immortal-sniper1/Ethernet_switch/Ethernet_switch_4out/DOCs/architecture.png

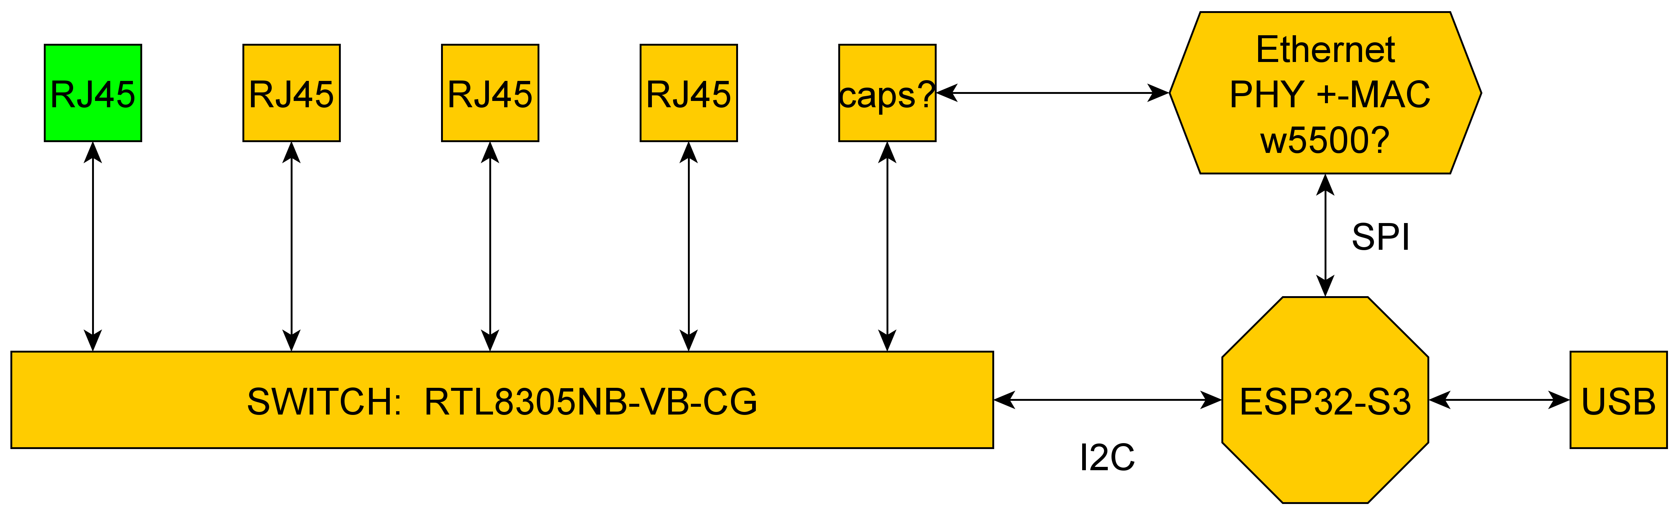
Ethernet_switch_4out/DOCs/architecture.png
