immortal-sniper1/Ethernet_switch/Ethernet_switch_4out/DOCs/pins1.png

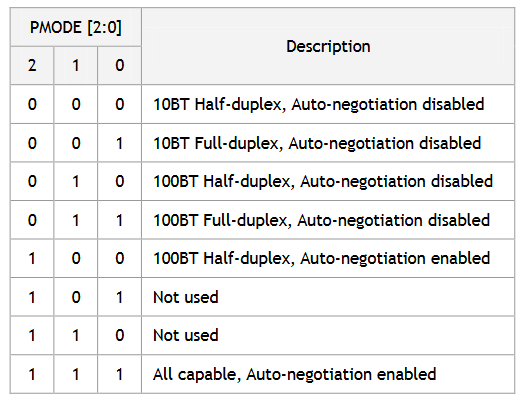
Ethernet_switch_4out/DOCs/pins1.png
