immortal-sniper1/Ethernet_switch/Ethernet_switch_4out/CASE/Ethernet_switch_4out-Margin.dxf

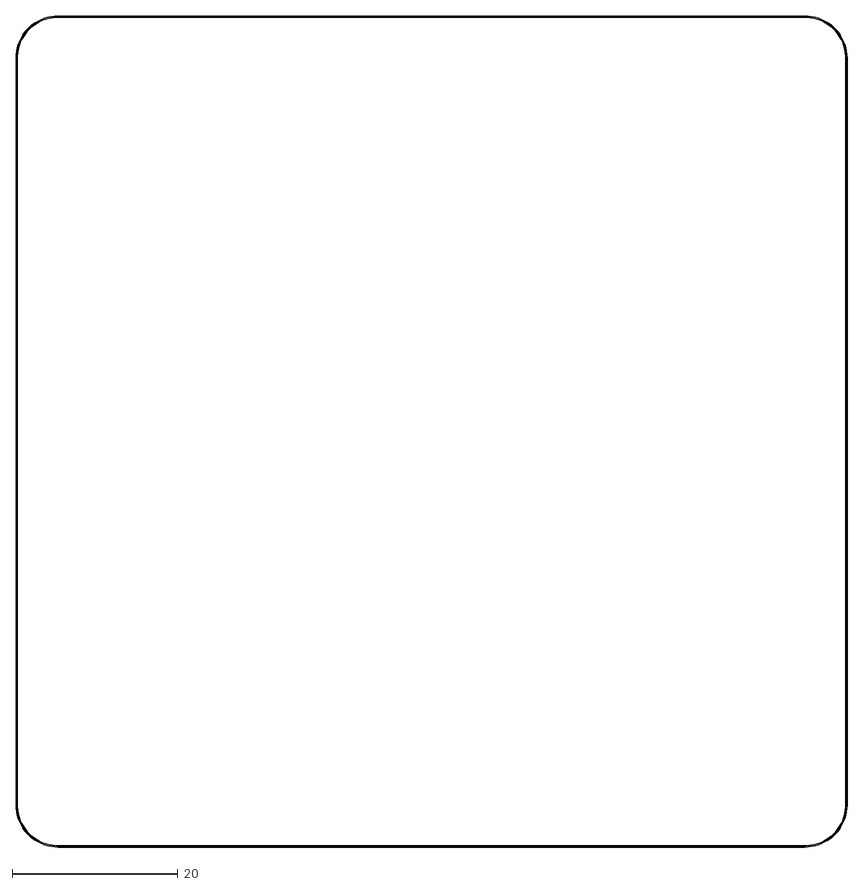
[picture p3: CAD file, 2023-08-01]
Ethernet_switch_4out/CASE/Ethernet_switch_4out-Margin.dxf
100.1 x 100.1
