immortal-sniper1/Ethernet_switch/Ethernet_switch_4out/Ethernet_switch_4out.kicad_pcb

## KiCad design Ethernet_switch_4out/Ethernet_switch_4out.kicad_pcb (2023-06-29)

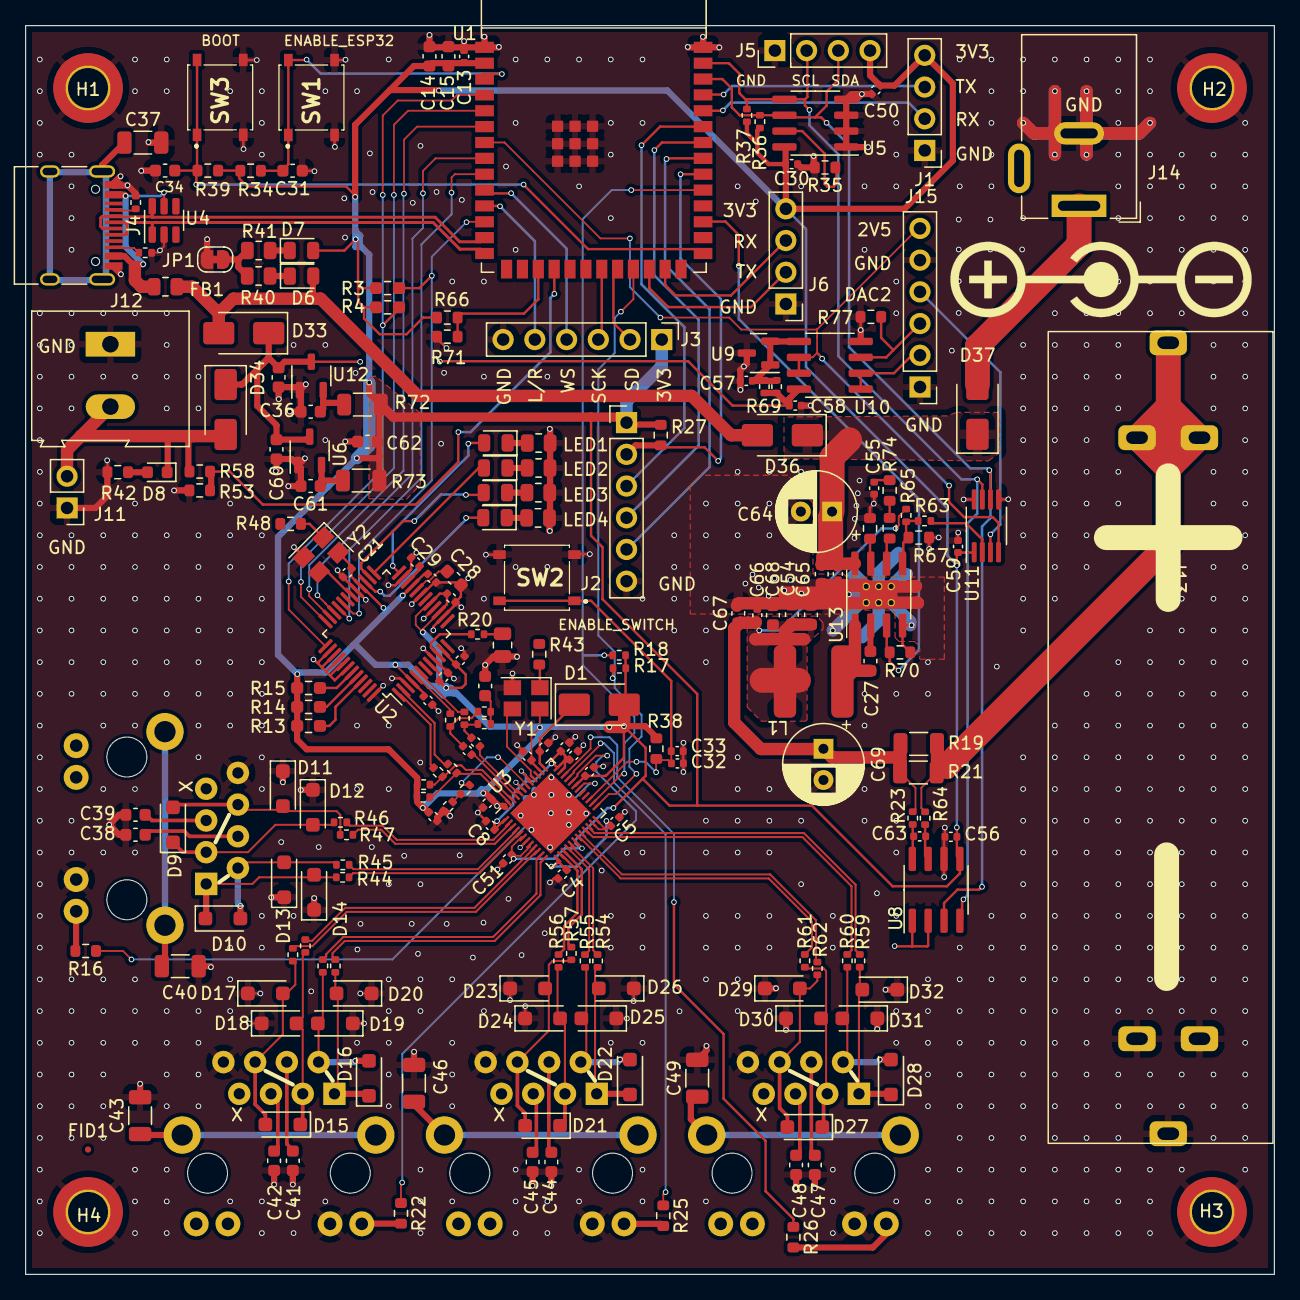
[picture p10: board Ethernet_switch_4out.kicad_pcb from above]

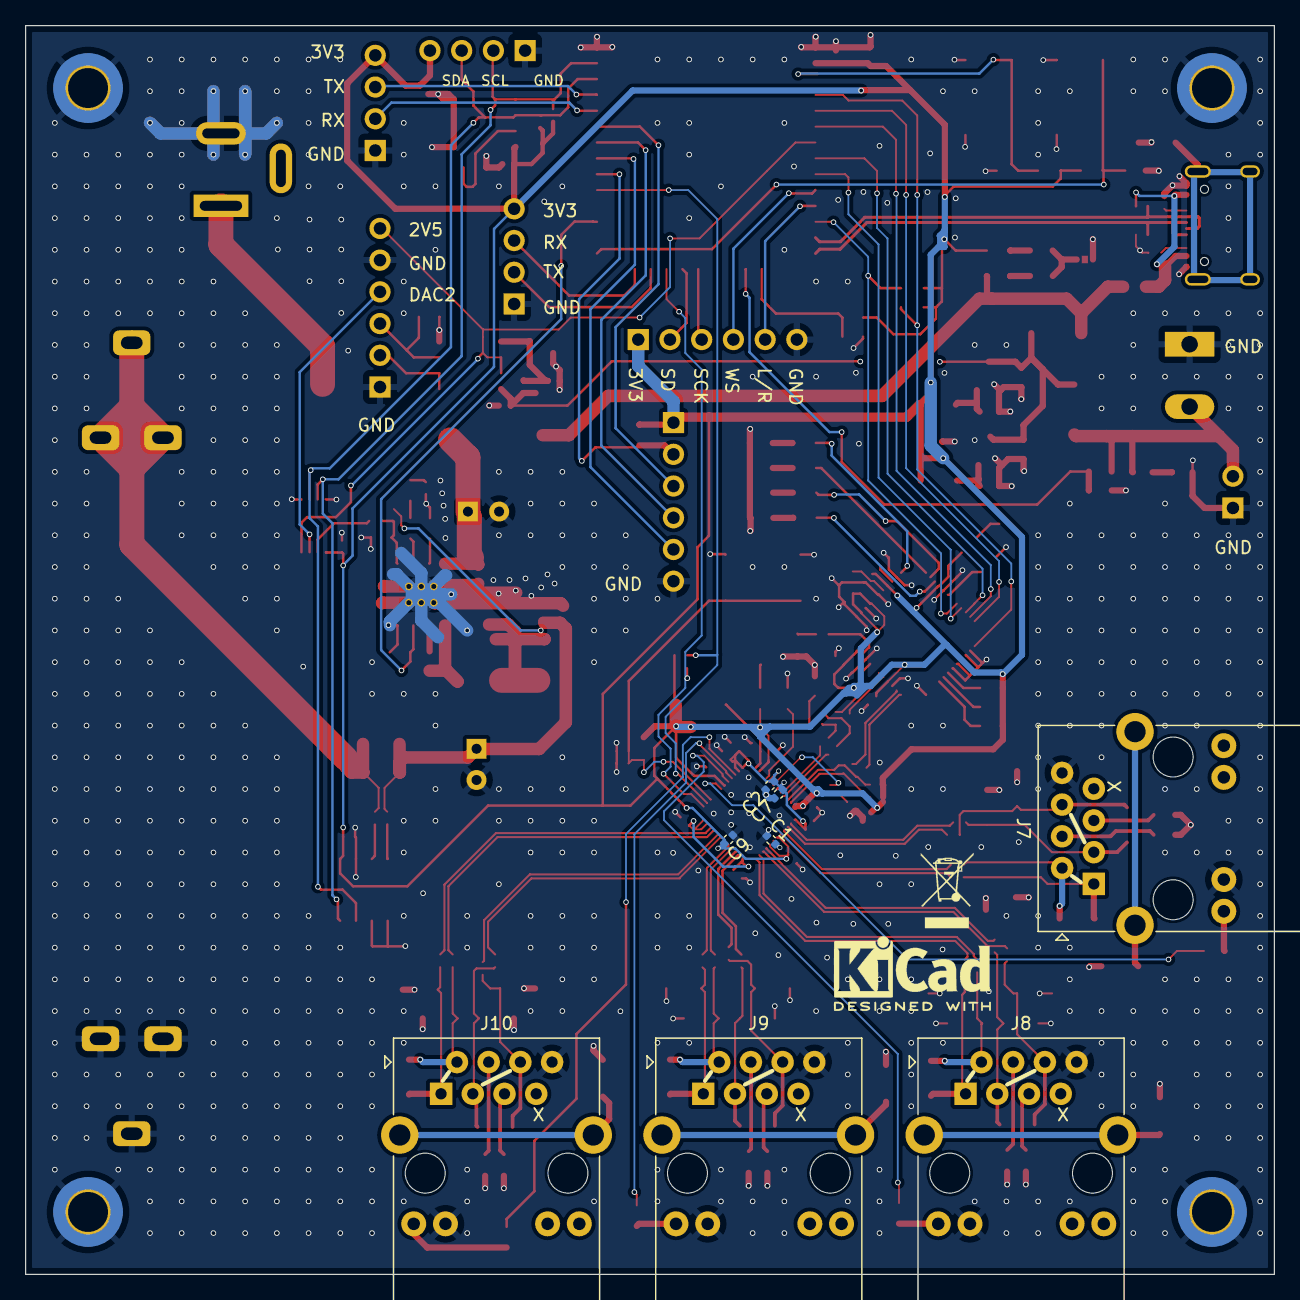
[picture p11: board Ethernet_switch_4out.kicad_pcb from below]

Board: 4 copper layers, 100.0 x 100.0 mm, 225 parts (10 on the bottom side), 151 nets.

Parts:
C1, C2, C3, C4, C5, C6, C7, C8, C9, C10, C11, C12, C13, C16, C17, C18, C19, C20, C21, C22, C25, C29, C30, C32, C33, C50, C51, C52, C56, C57, C58, C59, C66: 1u; C_0402_1005Metric
C14, C15, C28, C35, C36, C53, C54, C60, C61, C62, C65, C67, C68: 10u; C_0603_1608Metric
C23, C24: 6n8; C_0402_1005Metric
C26: 10n; C_0603_1608Metric
C27, C31, C34, C38, C39, C41, C42, C44, C45, C47, C48: 100n; C_0603_1608Metric
C37, C40, C43, C46, C49: 1n; C_1206_3216Metric
C55, C63: 4n7; C_0402_1005Metric
C64, C69: C_Polarized_Small; CP_Radial_D6.3mm_P2.50mm
D1, D33, D34, D36, D37: D_Schottky; D_SMA
D2, D3, D4, D5, D6, D7: green; LED_0805_2012Metric
D8: red; LED_0603_1608Metric
D9, D10, D11, D12, D13, D14, D15, D16, D17, D18, D19, D20, D21, D22, D23, D24, D25, D26, D27, D28, D29, D30, D31, D32: SMF6.0CA; D_SOD-123F
FB1: FerriteBead_Small; R_0805_2012Metric
FID1: Fiducial; Fiducial_0.5mm_Mask1mm
FID2: Fiducial; KiCad-Logo2_5mm_SilkScreen
FID3: Fiducial; WEEE-Logo_4.2x6mm_SilkScreen
FID4: Polarity; Polarity_Center_Positive_6mm_SilkScreen
H1, H2, H3, H4: hole; MountingHole_3.2mm_M3_DIN965_Pad_TopBottom
J1, J5, J6: Conn_01x04; PinHeader_1x04_P2.54mm_Vertical
J2, J3, J15: Conn_01x06; PinHeader_1x06_P2.54mm_Vertical
J4: USB_C_Receptacle; USB_C_Receptacle_HRO_TYPE-C-31-M-12
J7, J8, J9, J10: RJ45 Abracon ARJM11B1; RJ45_Abracon_ARJM11B1
J11: Conn_01x02; PinHeader_1x02_P2.54mm_Vertical
J12: Conn_01x02; TerminalBlock_Altech_AK300-2_P5.00mm
J13: Conn_01x02; MYOUNG MY-18650-01
J14: Jack-DC; BarrelJack_Wuerth_6941xx301002
JP1: Jumper_2_Bridged; SolderJumper-2_P1.3mm_Bridged_RoundedPad1.0x1.5mm
L1: 33u; SWPA6045S330MT
R1, R2, R9, R10: 49R9; R_0402_1005Metric
R3, R4, R13, R14, R15: 10k; R_0603_1608Metric_Pad0.98x0.95mm_HandSolder
R5, R6, R7, R8, R44, R45, R46, R47, R49, R50, R51, R52, R54, R55, R56, R57, R59, R60, R61, R62: 10; R_0402_1005Metric
R11, R69: 2k; R_0402_1005Metric
R12, R20, R68: 470; R_0402_1005Metric
R16, R22, R25, R26, R42: 1k; R_0603_1608Metric
R17, R18: 3k9; R_0402_1005Metric
R19, R21, R72, R73: 0R1; R_1206_3216Metric
R23, R64: 5R1; R_0402_1005Metric
R24: 12k; R_0805_2012Metric
R27, R34, R35, R38, R39, R53, R58, R66, R67, R70, R71, R74, R75: 10k; R_0603_1608Metric
R28, R29, R30, R31, R40, R41: 1k; R_0805_2012Metric
R32, R33, R36, R37: 5k1; R_0402_1005Metric
R43, R48: 2k; R_0603_1608Metric
R63, R65: 47k; R_0402_1005Metric
R76, R77: 120k; R_0603_1608Metric
SW1, SW2, SW3: MCU_RESET; PTS526SK15SMTR2LFS
U1: ESP32-S3-WROOM-1
U2: W5500; LQFP-48_7x7mm_P0.5mm
U3: RTL8305NB-VB-CG; QFN-48-1EP_6x6mm_P0.4mm_EP4.6x4.6mm
U4: SRV05-4; SOT-23-6
U5: CAT24C256; SOIC-8_3.9x4.9mm_P1.27mm
U6, U12: XC6206PxxxMR; SOT-23-3
U8: INA219AxD; SOIC-8_3.9x4.9mm_P1.27mm
U9: CJ431; SOT-23
U10: MCP6002-xSN; SOIC-8_3.9x4.9mm_P1.27mm
U11: AD5337; MSOP-8_3x3mm_P0.65mm
U13: RT7272B; SOIC-8-1EP_3.9x4.9mm_P1.27mm_EP2.29x3mm_ThermalVias
Y1, Y2: 25MHz; Crystal_SMD_3225-4Pin_3.2x2.5mm

Connections:
1V2: C1.2, C2.2, C3.2, C4.2, C5.2, C6.2, C7.2, C8.2, U3.1 (AVDDL), U3.7 (DVDDL), U3.13 (AVDDL), U3.23 (AVDDL), U3.24 (DVDDL), U3.35 (DVDDL), U3.36 (V12OUT), U3.41 (AVDDLPLL), U3.43 (AVDDL)
+3V3: C9.2, C10.2, C11.2, C12.2, C13.2, C14.1, C15.1, C17.2, C18.2, C19.2, C20.2, C21.2, C22.2, C25.2, C30.2, C50.2, C51.2, C56.2, C59.2, C62.1, D1.2 (A), D7.2 (A), J1.4, J2.1, J3.1, J5.4, J6.4, R1.2, R2.2, R3.1, R4.1, R13.2, R14.2, R15.2, R17.1, R18.1, R27.1, R34.1, R36.1, R37.1, R38.2, R39.2, R66.1, R72.1, R73.1, U1.2 (3V3), U2.4 (AVDD), U2.8 (AVDD), U2.11 (AVDD), U2.15 (AVDD), U2.17 (AVDD), U2.21 (AVDD), U2.28 (VDD), U3.6 (AVDDH), U3.8 (AVDDH), U3.18 (AVDDH), U3.31 (DVDDH), U3.38 (AVDDHPLL), U3.48 (AVDDH), U5.8 (VCC), U8.5 (VS), U11.1 (VDD), Y1.4, Y2.4
+5V: D6.2 (A), D33.2 (A), D36.2 (A), FB1.1
+BATT: D8.1 (K), D34.2 (A), J11.2, J12.2, R58.1
+VDC: C35.1, C58.2, C60.1, D33.1 (K), D34.1 (K), R68.2, R69.1, U6.3 (VI), U10.8 (V+), U12.3 (VI)
/2V5_RAW: C57.2, R68.1, R69.2, U9.1 (REF), U9.2 (K), U10.5 (+)
/Cell/BUCK_EN: R70.1, U1.29 (SPIIO7/GPIO36/FSPICLK/SUBSPICLK), U13.3 (EN)
/Cell/Buck_out: C54.1, C65.1, C66.2, C67.1, C68.1, C69.1, L1.2, R19.1, R21.1, R23.1, R65.2
/Cell/DAC1: R63.1, U11.2 (Vout_A)
/Cell/DAC2: J15.4, U11.3 (Vout_B)
/Cell/FB: R63.2, R65.1, R67.1, U13.5 (FB)
/Cell/Rlim: R76.1, U13.7 (RLIM)
/Cell/SW: C27.1, L1.1, U13.1 (SW)
/Cell/Vin_buck: C52.2, C53.1, C64.1, D36.1 (K), D37.1 (K), U13.8 (VIN)
/Cell/boot: C27.2, U13.2 (BOOT)
/Cell_V: R53.1, R58.2, U1.18 (GPIO10/TOUCH10/ADC1_CH9/FSPICS0/FSPIIO4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)
/ESP_BOOT: C34.1, R39.1, SW3.1 (A), U1.27 (GPIO0/BOOT)
/ESP_EN: C31.2, R34.2, SW1.1 (A), U1.3 (EN)
/L/R: J3.5, U1.11 (GPIO18/U1RXD/ADC2_CH7/CLK_OUT3)
/MISO: U1.8 (GPIO15/U0RTS/ADC2_CH4/XTAL_32K_P), U2.34 (MISO)
/MOSI: U1.6 (GPIO6/TOUCH6/ADC1_CH5), U2.35 (MOSI)
/Output_port1/GREEN: J8.9 (LEDG_A), R22.2
/Output_port1/L_RD+: D15.1 (A1), D18.2 (A2), J8.3 (RD+), R51.2
/Output_port1/L_RD-: D15.2 (A2), D17.2 (A2), J8.6 (RD-), R52.2
/Output_port1/L_TD+: D16.1 (A1), D20.2 (A2), J8.1 (TD+), R49.2
/Output_port1/L_TD-: D16.2 (A2), D19.2 (A2), J8.2 (TD-), R50.2
/Output_port1/RD+: R51.1, U3.9 (TXOP2)
/Output_port1/RD-: R52.1, U3.10 (TXON2)
/Output_port1/TD+: R49.1, U3.12 (RXOP2)
/Output_port1/TD-: R50.1, U3.11 (RXON2)
/Output_port2/GREEN: J9.9 (LEDG_A), R25.2
/Output_port2/L_RD+: D21.1 (A1), D24.2 (A2), J9.3 (RD+), R56.2
/Output_port2/L_RD-: D21.2 (A2), D23.2 (A2), J9.6 (RD-), R57.2
/Output_port2/L_TD+: D22.1 (A1), D26.2 (A2), J9.1 (TD+), R54.2
/Output_port2/L_TD-: D22.2 (A2), D25.2 (A2), J9.2 (TD-), R55.2
/Output_port2/RD+: R56.1, U3.14 (RXIP3)
/Output_port2/RD-: R57.1, U3.15 (RXIN3)
/Output_port2/TD+: R54.1, U3.17 (TXOP3)
/Output_port2/TD-: R55.1, U3.16 (TXON3)
/Output_port3/GREEN: J10.9 (LEDG_A), R26.2
/Output_port3/L_RD+: D27.1 (A1), D30.2 (A2), J10.3 (RD+), R61.2
/Output_port3/L_RD-: D27.2 (A2), D29.2 (A2), J10.6 (RD-), R62.2
/Output_port3/L_TD+: D28.1 (A1), D32.2 (A2), J10.1 (TD+), R59.2
/Output_port3/L_TD-: D28.2 (A2), D31.2 (A2), J10.2 (TD-), R60.2
/Output_port3/RD+: R61.1, U3.19 (TXOP4)
/Output_port3/RD-: R62.1, U3.20 (TXON4)
/Output_port3/TD+: R59.1, U3.22 (RXOP4)
/Output_port3/TD-: R60.1, U3.21 (RXON4)
/Output_port/GREEN: J7.9 (LEDG_A), R16.2
/Output_port/L_RD+: D9.1 (A1), D12.2 (A2), J7.3 (RD+), R46.2
/Output_port/L_RD-: D9.2 (A2), D11.2 (A2), J7.6 (RD-), R47.2
/Output_port/L_TD+: D10.1 (A1), D14.2 (A2), J7.1 (TD+), R44.2
/Output_port/L_TD-: D10.2 (A2), D13.2 (A2), J7.2 (TD-), R45.2
/Output_port/RD+: R46.1, U3.2 (RXIP1)
/Output_port/RD-: R47.1, U3.3 (RXIN1)
/Output_port/TD+: R44.1, U3.5 (TXIP1)
/Output_port/TD-: R45.1, U3.4 (TXIN1)
/Rail_V: R66.2, R71.1, U1.17 (GPIO9/TOUCH9/ADC1_CH8/FSPIHD/SUBSPIHD)
/SCK: J3.3, U1.21 (GPIO13/TOUCH13/ADC2_CH2/FSPIQ/FSPIIO7/S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)
/SCLK: U1.9 (GPIO16/U0CTS/ADC2_CH5/XTAL_32K_N), U2.33 (SCLK)
/SD: J3.2, U1.22 (GPIO14/TOUCH14/ADC2_CH3/FSPIWP/FSPIDQS/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)
/SWITCH_EN: C32.2, C33.2, R38.1, SW2.1 (A), U3.27 (RESET_B)
/W5500_LED1: D5.2 (A), U2.24 (SPDLED)
/W5500_LED2: D4.2 (A), U2.25 (LINKLED)
/W5500_LED3: D3.2 (A), U2.26 (DUPLED)
/W5500_LED4: D2.2 (A), U2.27 (ACTLED)
/WS: J3.4, U1.10 (GPIO17/U1TXD/ADC2_CH6)
/cc1: J4.A5 (CC1), R32.1
/cc2: J4.B5 (CC2), R33.1
/green_LED1: R16.1, U3.30 (P1LED)
/green_LED2: R22.1, U3.32 (P2LED/DIS_RST_BLNK)
/green_LED3: R25.1, U3.33 (P3LED)
/green_LED4: R26.1, U3.34 (P4LED)
/~INT: U1.5 (GPIO5/TOUCH5/ADC1_CH4), U2.36 (~INT)
/~RST: R4.2, U1.4 (GPIO4/TOUCH4/ADC1_CH3), U2.37 (~RST)
/~SCS: R3.2, U1.12 (GPIO8/TOUCH8/ADC1_CH7/SUBSPICS1), U2.32 (~SCS)
CLK_EXT: J2.3, U1.35 (MTMS/GPIO42)
D+: J4.A6 (D+), J4.B6 (D+), U1.14 (GPIO20/U1CTS/ADC2_CH9/CLK_OUT1/USB_D+), U4.1 (IO1)
D-: J4.A7 (D-), J4.B7 (D-), U1.13 (GPIO19/U1RTS/ADC2_CH8/CLK_OUT2/USB_D-), U4.6 (IO4)
GND: C1.1, C2.1, C3.1, C4.1, C5.1, C6.1, C7.1, C8.1, C9.1, C10.1, C11.1, C12.1, C13.1, C14.2, C15.2, C16.1, C17.1, C18.1, C19.1, C20.1, C21.1, C22.1, C25.1, C26.1, C28.1, C29.1, C30.1, C31.1, C32.1, C33.1, C34.2, C35.2, C36.2, C37.2, C38.1, C39.1, C40.2, C41.1, C42.1, C43.2, C44.1, C45.1, C46.2, C47.1, C48.1, C49.2, C50.1, C51.1, C52.1, C53.2, C54.2, C55.2, C56.1, C57.1, C58.1, C59.1, C60.2, C61.2, C62.2, C64.2, C65.2, C66.1, C67.2, C68.2, C69.2, D11.1 (A1), D12.1 (A1), D13.1 (A1), D14.1 (A1), D17.1 (A1), D18.1 (A1), D19.1 (A1), D20.1 (A1), D23.1 (A1), D24.1 (A1), D25.1 (A1), D26.1 (A1), D29.1 (A1), D30.1 (A1), D31.1 (A1), D32.1 (A1), H1.1, H2.1, H3.1, H4.1, J1.1, J2.6, J3.6, J4.A1 (GND), J4.A12 (GND), J4.B1 (GND), J4.B12 (GND), J5.1, J6.1, J7.8 (GND), J7.10 (LEDG_K), J8.8 (GND), J8.10 (LEDY_K), J9.8 (GND), J9.10 (LEDY_K), J10.8 (GND), J10.10 (LEDY_K), J11.1, J12.1, J13.2, J14.2, J15.1, J15.5, JP1.1 (A), R11.1, R24.2, R28.2, R29.2, R30.2, R31.2, R32.2, R33.2, R35.2, R42.1, R53.2, R67.2, R70.2, R71.2, R76.2, R77.2, SW1.2 (B), SW2.2 (B), SW3.2 (B), U1.1 (GND), U1.40 (GND), U1.41 (GND), U2.3 (AGND), U2.9 (AGND), U2.14 (AGND), U2.16 (AGND), U2.19 (AGND), U2.23 (RSVD), U2.29 (GND), U2.38 (RSVD), U2.39 (RSVD), U2.40 (RSVD), U2.41 (RSVD), U2.42 (RSVD), U2.48 (AGND), U3.49 (GND/EP), U4.2 (VN), U5.1 (A0), U5.2 (A1), U5.3 (A2), U5.4 (GND), U6.1 (GND), U8.1 (A1), U8.2 (A0), U8.6 (GND), U9.3 (A), U10.4 (V-), U11.5 (GND), U11.8 (A0), U12.1 (GND), U13.4 (GND), U13.9 (PAD), Y1.2, Y2.2
MISO_EXT: J2.5, U1.33 (MTDO/GPIO40/CLK_OUT2)
MOSI_EXT: J2.4, U1.34 (MTDI/GPIO41/CLK_OUT1)
unnamed: C23.1, R5.1, R10.2
unnamed: C24.1, R6.1, R9.2
unnamed: C26.2, R9.1, R10.1
unnamed: C55.1, R74.2
unnamed: C16.2, D1.1 (K), U3.37 (V33IN)
unnamed: D2.1 (K), R28.1
unnamed: D3.1 (K), R29.1
unnamed: D4.1 (K), R30.1
unnamed: D5.1 (K), R31.1
unnamed: D6.1 (K), R40.1
unnamed: D7.1 (K), R41.1
unnamed: D8.2 (A), R42.2
unnamed: D37.2 (A), J14.1
unnamed: J1.2, U1.36 (U0RXD/GPIO44/CLK_OUT2)
unnamed: J1.3, U1.37 (U0TXD/GPIO43/CLK_OUT1)
unnamed: C37.1, J4.S1 (SHIELD)
unnamed: C39.2, J7.5 (RCT)
unnamed: C40.1, J7.15 (SHIELD)
unnamed: C38.2, J7.4 (TCT)
unnamed: C42.2, J8.5 (RCT)
unnamed: C43.1, J8.15 (SHIELD)
unnamed: C41.2, J8.4 (TCT)
unnamed: C45.2, J9.5 (RCT)
unnamed: C46.1, J9.15 (SHIELD)
unnamed: C44.2, J9.4 (TCT)
unnamed: C48.2, J10.5 (RCT)
unnamed: C49.1, J10.15 (SHIELD)
unnamed: C47.2, J10.4 (TCT)
unnamed: J13.1, R19.2, R21.2, R64.1
unnamed: J15.2, U10.1, U10.2 (-)
unnamed: J15.3, R77.1, U10.3 (+)
unnamed: JP1.2 (B), R40.2, R41.2
unnamed: R11.2, R12.1
unnamed: R20.1, R24.1
unnamed: R43.2, Y1.1
unnamed: R48.2, Y2.1
unnamed: R74.1, R75.2
unnamed: C29.2, U2.22 (1V2O)
unnamed: R20.2, U2.10 (EXRES1)
unnamed: R13.1, U2.45 (PMODE0)
unnamed: R14.1, U2.44 (PMODE1)
unnamed: R15.1, U2.43 (PMODE2)
unnamed: R6.2, U2.5 (RXN)
unnamed: R5.2, U2.6 (RXP)
unnamed: C28.2, U2.20 (TOCAP)
unnamed: R7.2, U2.1 (TXN)
unnamed: R8.2, U2.2 (TXP)
unnamed: U2.30 (XI/CLKIN), Y2.3
unnamed: R12.2, U3.42 (IBREF)
unnamed: C24.2, U3.45 (RXIN0)
unnamed: C23.2, U3.44 (RXIP0)
unnamed: R1.1, R7.1, U3.46 (TXIN0)
unnamed: R2.1, R8.1, U3.47 (TXIP0)
unnamed: U3.40 (XI), Y1.3
unnamed: R35.1, U5.7 (WP)
unnamed: C61.1, R73.2, U6.2 (VO)
unnamed: C63.1, R23.2, U8.8 (IN+)
unnamed: C63.2, R64.2, U8.7 (IN-)
unnamed: C36.1, R72.2, U12.2 (VO)
unnamed: R75.1, U13.6 (COMP)
REF_2v5: J15.6, U1.7 (GPIO7/TOUCH7/ADC1_CH6), U10.6 (-), U10.7, U11.4 (REF)
RX: J6.3, U1.25 (GPIO48/SPICLK_N/SUBSPICLK_N_DIFF)
SCL: J5.2, R37.2, U1.39 (GPIO1/TOUCH1/ADC1_CH0), U5.5 (SDA), U8.4 (SCL), U11.7 (SCL)
SCL/MDC: R17.2, U1.23 (GPIO21), U3.25 (SCL/MDC)
SDA: J5.3, R36.2, U1.38 (GPIO2/TOUCH2/ADC1_CH1), U5.6 (SCL), U8.3 (SDA), U11.6 (SDA)
SDA/MDIO: R18.2, U1.31 (GPIO38/FSPIWP/SUBSPIWP), U3.26 (SDA/MDIO)
SS_EXT: J2.2, R27.2, U1.32 (MTCK/GPIO39/CLK_OUT3/SUBSPICS1)
TX: J6.2, U1.24 (GPIO47/SPICLK_P/SUBSPICLK_P_DIFF)
VBUS: FB1.2, J4.A4 (VBUS), J4.A9 (VBUS), J4.B4 (VBUS), J4.B9 (VBUS), U4.5 (VP)
